wwwwyyykkk/-Fatigue-Detection/docs/答辩流程与讲稿.md

# 疲劳驾驶检测系统 —— 毕业设计答辩

## ⏱ 时间分配（共 15 分钟：10 分钟演示 + 5 分钟问答）

| 环节 | 时长 | 内容 |
|---|---|---|
| ① 开场 | 30s | 自我介绍 + 题目 |
| ② 背景意义 | 1min | 为什么做、市场价值 |
| ③ 系统架构 | 1.5min | 三板分工 + 数据流 |
| ④ 硬件设计 | 1min | 选型 + 接线 |
| ⑤ 软件原理 | 2min | 疲劳检测/预测/哈欠/休息 |
| ⑥ 现场演示 | 3min | 全链路实操 |
| ⑦ 创新点 | 1min | 3 个核心创新 |
| ⑧ 总结展望 | 30s | 局限 + 未来 |

---

## ① 开场（30 秒）

> 各位老师好！我是 XXX，我的毕业设计题目是《基于 ESP32-S3 的疲劳驾驶检测系统》。
> 下面我将从研究背景、系统设计、技术实现、现场演示四个方面进行汇报。

---

## ② 研究背景与意义（1 分钟）

> 根据公安部交通管理局数据，**疲劳驾驶是引发重特大交通事故的首要原因之一**，
> 约占高速公路交通事故的 20%-25%。疲劳驾驶具有突发性、隐蔽性，驾驶员往往在
> 事故发生前自己都意识不到。
>
> 目前市面上的产品分两类：
> - **前装 DMS**（特斯拉、理想等）：需要原厂集成，普通车辆无法加装
> - **后装 DMS**：动辄数千元，且多是"检测到疲劳才报警"的被动响应
>
> 我的设计目标是：**低成本（总成本约 ¥200）、边缘计算、主动预测**的
> 疲劳驾驶检测系统，让普通车辆也能享受疲劳预警保护。

---

## ③ 系统总体架构（1.5 分钟）

> 系统采用**双 ESP32-S3 + 4G 模组 + 云端**的三层架构：

```
┌────────────────────────────────────────────────────┐
│                  云端（Flask 网页）                  │
│      高德地图 · PERCLOS仪表盘 · 事件时间线 · 天气      │
└──────────────────────┬─────────────────────────────┘
                       │ 华为云 IoTDA（MQTT）
┌──────────────────────┴─────────────────────────────┐
│        EG800K 4G 模组（QuecPython）                  │
│        数据透传 · 模拟GPS轨迹 · MQTT上传              │
└──────────────────────┬─────────────────────────────┘
                       │ UART1
┌──────────────────────┴───────────┐  ┌───────────────┐
│   主板 ESP32-S3                   │  │  VirtualGPS    │
│   USB摄像头 → 人脸检测             │←┼→│  按钮/OLED/TTS  │
│   → 眼睛ROI → PERCLOS             │  │  Rainmaker远程 │
│   → 哈欠检测 → 疲劳预测            │  │  ESP-SR语音    │
│   → 休息管理 → TFT显示             │  │               │
└───────────────────────────────────┘  └───────────────┘
```

> **主板**负责核心的视觉疲劳检测，**VirtualGPS** 负责模拟驾驶环境
> （速度/位置/司机/休息请求），**EG800K** 负责 4G 通信上传云端，
> 三块板通过串口和 ESP-NOW 通信，各司其职。

---

## ④ 硬件设计（1 分钟）

> - **主控**：ESP32-S3（240MHz 双核，16MB PSRAM）
> - **摄像头**：USB UVC 摄像头（720P，通过 USB-OTG 接口）
> - **显示**：ST7789 240×320 TFT 彩屏（SPI）
> - **语音**：SYN6288 TTS 语音合成（播报疲劳告警）
> - **通信**：EG800K 4G 模组 + ESP-NOW 无线板间通信
> - **传感器**：MQ3 酒精检测、INMP441 麦克风（语音识别）
>
> 总物料成本约 **¥200**，对比市面后装 DMS 数千元，具有明显成本优势。

---

## ⑤ 软件实现与技术原理（2 分钟）

### 5.1 疲劳检测（PERCLOS）

> 采用国际通用的 **PERCLOS（眼睛闭合时间百分比）** 指标：
> - 摄像头捕获面部 → ESP-DL 人脸检测模型定位人脸
> - 人脸框按比例切出眼睛 ROI → 缩放 96×96 灰度图
> - 送入 MobileNetV2 轻量神经网络（TFLite Micro）判断睁闭眼
> - 滑动窗口 30 帧计算 PERCLOS，阈值联动天气调整
>
> ```
> PERCLOS > 15% 轻度疲劳（晴天）   12% 雨天   10% 雾天
> PERCLOS > 30% 严重疲劳           25%        20%
> ```

### 5.2 打哈欠检测（暗区比例法）

> 传统打哈欠检测需要打哈欠数据集训练模型，我采用**暗区比例法**：
> - 打哈欠时口腔内部形成黑色空洞
> - 计算嘴巴 ROI 中心区域暗像素占比
> - 暗区比 > 35% 且持续 1.5 秒 → 判定为一次哈欠
>
> **零训练、零额外算力**，且不影响主检测链路。

### 5.3 疲劳预测（线性回归）

> 与市面"检测到才报警"不同，我的系统能**预测即将疲劳**：
> - 每 30 秒记录一次 PERCLOS 到环形缓冲（20 点）
> - 每 2 分钟用**线性回归**拟合上升斜率
> - 根据斜率推算到达疲劳阈值的时间
> - TFT 显示"预计 N 分钟后疲劳"+ 预测虚线
>
> 提前 5-15 分钟预警，让驾驶员有充足时间进服务区。

### 5.4 休息管理

> 疲劳告警后进入休息模式：
> - 轻度疲劳 → 建议休息 10 分钟；严重疲劳 → **强制休息 20 分钟**（不可提前退出）
> - 休息结束 → 对比休息前后 PERCLOS 计算**恢复率**
> - 恢复不足 40% → 自动延长休息
> - 休息完成 → **人脸重新验证**，防止换司机规避检测

### 5.5 云端监控

> 疲劳数据通过 4G 实时上传华为云，网页端实时显示：
> - 车辆位置（高德地图）+ 行驶轨迹
> - PERCLOS 仪表盘 + 安全评分
> - 疲劳/哈欠事件时间线
> - **天气联动**：雨雪雾自动降低检测阈值

---

## ⑥ 现场演示（3 分钟）

### 演示准备（提前做好）

```
1. Flask + ngrok 已启动
2. EG800K 已连接 4G（MQTT connect=0）
3. 三块板已烧录最新固件 + 已连接 WiFi
4. 串口 monitor 已开（COM16 主板 / COM18 VirtualGPS）
5. 浏览器打开 ngrok 网页
6. 手机打开 Rainmaker App
```

### 演示流程（对应 10 分钟脚本）

| 时间 | 操作 | 讲解要点 |
|---|---|---|
| 0:00 | 指 TFT + 摄像头 | "边缘 AI，本地推理，不依赖云端" |
| 0:30 | 输入 `demo` 命令 | "开启加速演示，5 秒采样，10 秒预测" |
| 1:00 | Rainmaker 拉 PERCLOS 5%→10% | 正常状态，绿色 |
| 1:30 | 拉到 14% | TFT 预测栏出现 "预测 2min" ← **亮点** |
| 2:00 | 拉到 18% | 触发轻度疲劳，TFT 变黄 |
| 2:30 | 对着摄像头打哈欠 | 哈欠+1，PERCLOS 加成+5% |
| 3:00 | 切服务区 + 按 BUTTON_3 | 进入休息，显示倒计时+恢复率 |
| 3:30 | 展示网页 | 地图 + PERCLOS 仪表盘 + 事件时间线 |
| 4:30 | 语音："Hi ESP，我累了" | ESP-SR 唤醒 → 命令识别 → 记录 |
| 5:00 | 总结 | 三个创新点收尾 |

---

## ⑦ 创新点总结（1 分钟）

> 总结本设计的三个核心创新点：
>
> **① 疲劳预测而非被动检测**
> 市面产品都是"检测到疲劳才报警"，本系统通过线性回归
> 预测 PERCLOS 上升趋势，**提前 5-15 分钟预警**。
>
> **② 零训练打哈欠检测**
> 采用暗区比例法识别口腔黑洞，无需训练数据集，
> 在 ESP32 上零额外算力开销，不影响主检测链路。
>
> **③ 低成本边缘 AI 全链路**
> 从图像采集、疲劳推理到 4G 上传，全部在嵌入式端完成，
> 总成本约 ¥200，并实现了天气联动降阈、远程监控、
> 强制休息管理、人脸身份验证等完整功能闭环。

---

## ⑧ 总结与展望（30 秒）

> 本设计实现了一套完整的疲劳驾驶检测系统，具有低成本、
> 边缘计算、主动预测的特点。由于时间限制，仍有改进空间：
> - 视线偏离/分心检测（Euro NCAP 2026 要求）
> - 真实 GNSS 定位替代模拟 GPS
> - 升级 ESP32-P4（带 NPU）跑更复杂的 LSTM 预测模型
>
> 我的汇报到此结束，谢谢各位老师！恳请老师们批评指正！

---

## ⑨ 问答环节准备（5 分钟）

### Q1：为什么用线性回归而不是机器学习？
> ESP32 资源有限（512KB SRAM），跑 LSTM 需要额外的模型部署
> 和训练数据。线性回归只需 80 字节存储、微秒级计算，
> 在嵌入式端实时运行，且可解释性强。论文调研显示，
> 这是嵌入式疲劳预测的主流轻量方案。

### Q2：PERCLOS 阈值为什么随天气变化？
> 雨雪雾天气能见度差、路面湿滑，驾驶员反应时间需要更长，
> 同样的闭眼比例在恶劣天气下风险更高。因此降阈以提前预警。

### Q3：摄像头夜间能用吗？
> 当前使用可见光摄像头，夜间光照不足时检测精度会下降。
> 这是后续可改进点——换用红外摄像头 + 补光灯可实现全天候检测。
> （诚实说明局限，再给方案）

### Q4：识别一张脸要多久？
> 眼部分类约 1.9 秒/帧，人脸识别约 12.6 秒。人脸识别仅在
> 开机、切司机、人脸长时间丢失时触发，不影响正常 PERCLOS
> 检测频率。

### Q5：断网会怎样？
> EG800K 断网时数据暂存在本地，恢复后补传（待实现，当前
> 演示环境网络稳定）。疲劳检测本身完全本地运行，不依赖网络。

### Q6：如何保证不误报？
> 三层校验：单帧睁闭眼由神经网络判断 → PERCLOS 需 30 帧
> 滑动窗口稳定 → 等级变化需持续采样确认。哈欠检测有
> 1.5 秒时长过滤，说话不会误触发。

---

## 演示 Checklist（答辩当天早上）

- [ ] 三块板充满电/接好电源，共地
- [ ] 摄像头清晰、无遮挡
- [ ] 主板/ VirtualGPS 串口 monitor 各一个
- [ ] Flask 启动 + ngrok 在线
- [ ] EG800K SIM 卡有流量
- [ ] 浏览器网页打开正常
- [ ] Rainmaker App 登录正常
- [ ] 提前跑一遍完整 demo 确认所有功能
- [ ] 备用：U 盘备份固件 bin + 串口工具
