wwwwyyykkk/-Fatigue-Detection/docs/images/全链路数据流图.png

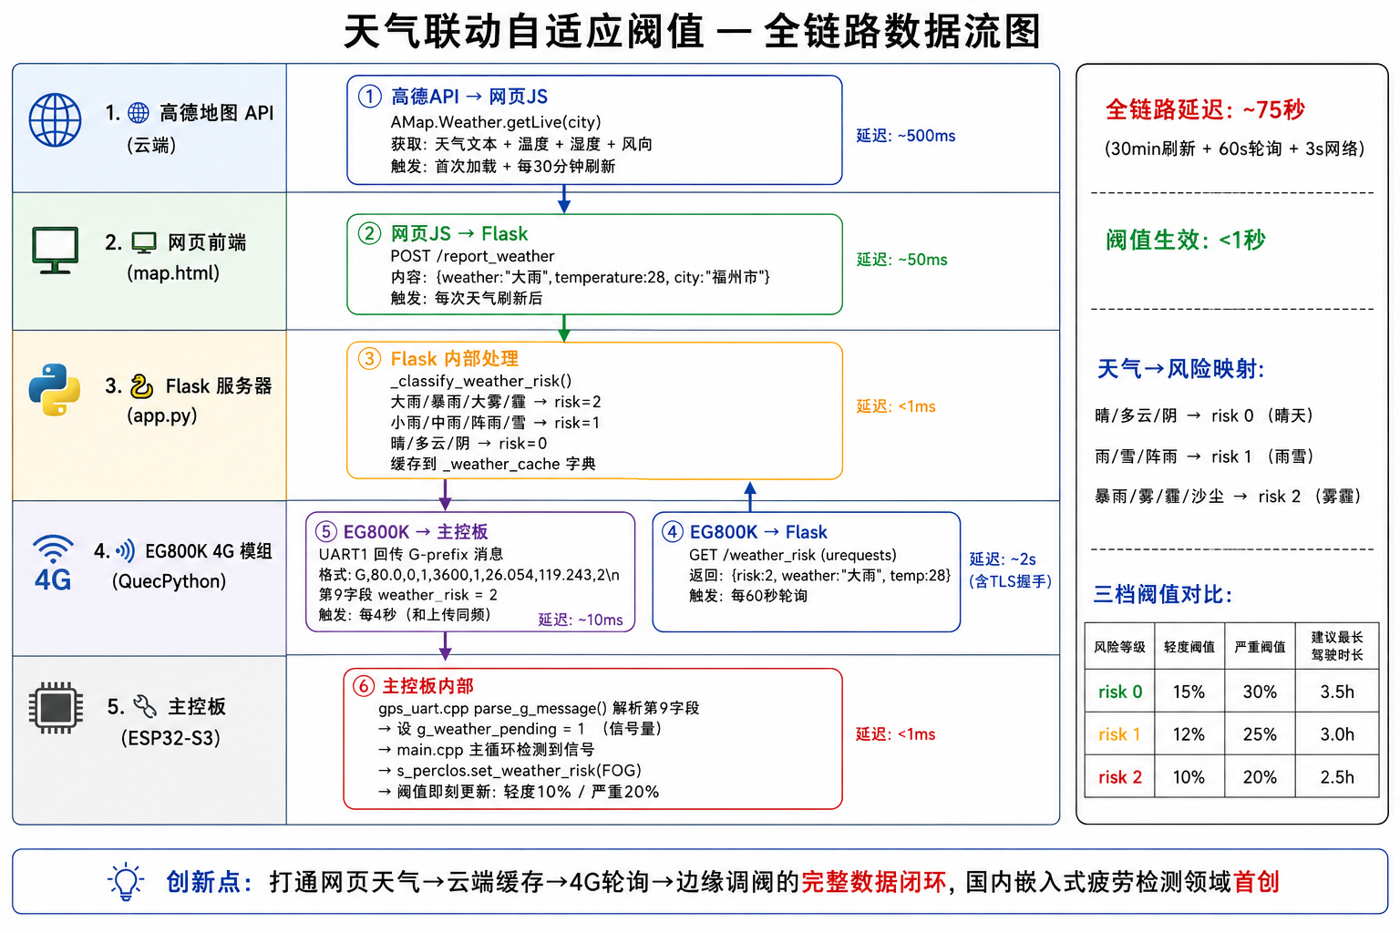
docs/images/全链路数据流图.png
