wwwwyyykkk/-Fatigue-Detection/docs/images/单帧处理管线.png

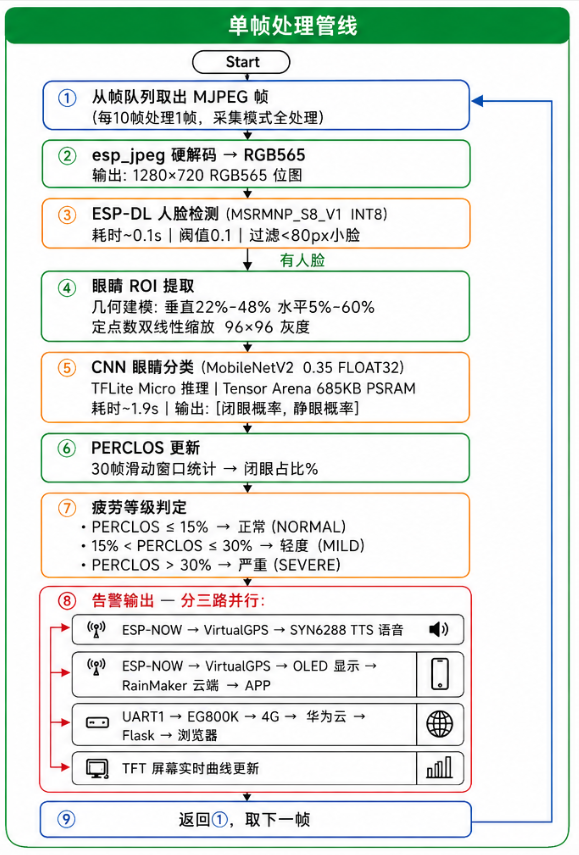
docs/images/单帧处理管线.png
