wwwwyyykkk/-Fatigue-Detection/virtualgps/ESP32S3引脚图.png

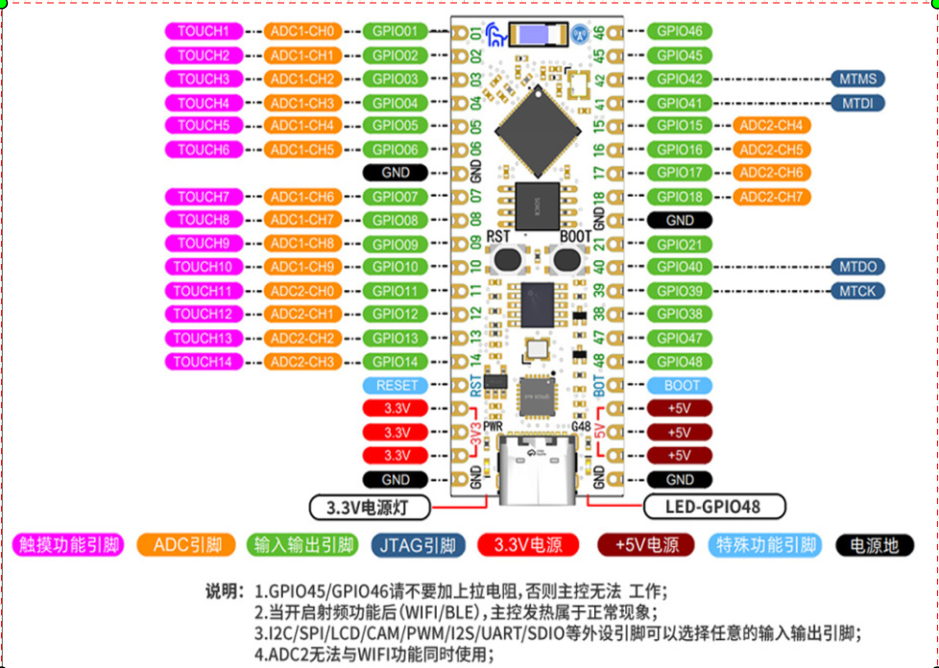
virtualgps/ESP32S3引脚图.png
