wwwwyyykkk/-Fatigue-Detection/virtualgps/ESP32原理图引脚.png

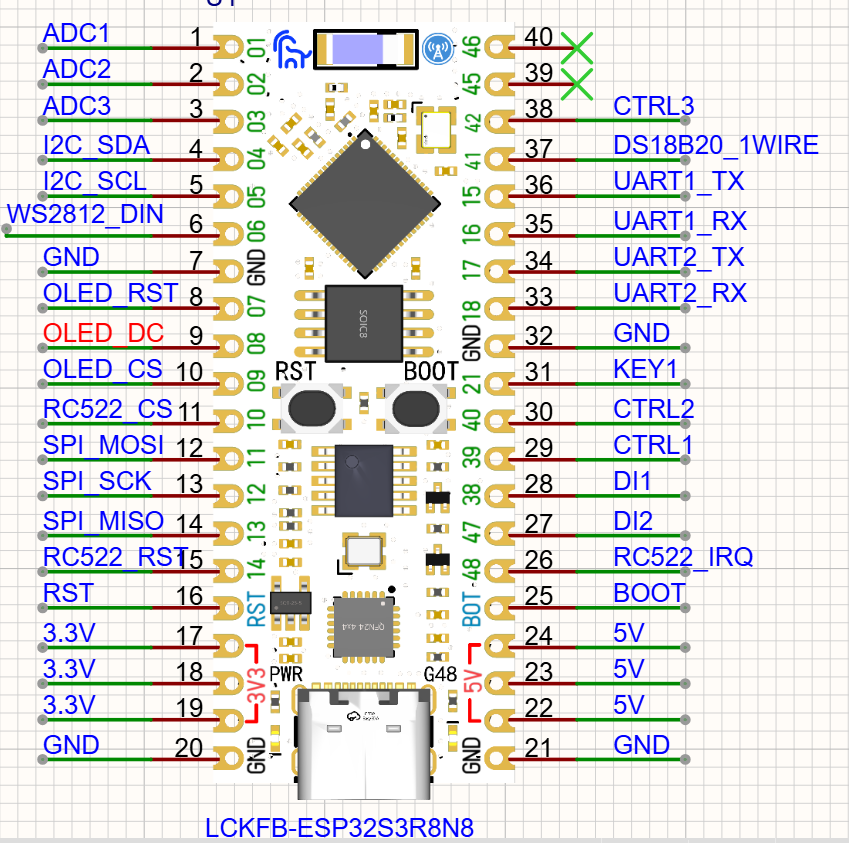
virtualgps/ESP32原理图引脚.png
