wwwwyyykkk/-Fatigue-Detection/main/lv_font_fancy_44.c

/* lv_font_fancy_44.c — HOLLOW script clock font (thicken 3) */
#include "lvgl.h"

static const lv_font_fmt_txt_glyph_dsc_t glyph_dsc[] = {
    {.bitmap_index = 0, .adv_w = 512, .box_w = 32, .box_h = 56, .ofs_x = 0, .ofs_y = 0},
    {.bitmap_index = 224, .adv_w = 256, .box_w = 16, .box_h = 56, .ofs_x = 0, .ofs_y = 0},
    {.bitmap_index = 336, .adv_w = 512, .box_w = 32, .box_h = 56, .ofs_x = 0, .ofs_y = 0},
    {.bitmap_index = 560, .adv_w = 512, .box_w = 32, .box_h = 56, .ofs_x = 0, .ofs_y = 0},
    {.bitmap_index = 784, .adv_w = 512, .box_w = 32, .box_h = 56, .ofs_x = 0, .ofs_y = 0},
    {.bitmap_index = 1008, .adv_w = 512, .box_w = 32, .box_h = 56, .ofs_x = 0, .ofs_y = 0},
    {.bitmap_index = 1232, .adv_w = 512, .box_w = 32, .box_h = 56, .ofs_x = 0, .ofs_y = 0},
    {.bitmap_index = 1456, .adv_w = 512, .box_w = 32, .box_h = 56, .ofs_x = 0, .ofs_y = 0},
    {.bitmap_index = 1680, .adv_w = 512, .box_w = 32, .box_h = 56, .ofs_x = 0, .ofs_y = 0},
    {.bitmap_index = 1904, .adv_w = 512, .box_w = 32, .box_h = 56, .ofs_x = 0, .ofs_y = 0},
    {.bitmap_index = 2128, .adv_w = 512, .box_w = 32, .box_h = 56, .ofs_x = 0, .ofs_y = 0},
    {.bitmap_index = 2352, .adv_w = 512, .box_w = 32, .box_h = 56, .ofs_x = 0, .ofs_y = 0},
    {.bitmap_index = 2576, .adv_w = 256, .box_w = 16, .box_h = 56, .ofs_x = 0, .ofs_y = 0},
};

static const uint8_t glyph_bitmap[] = {
    // U+002D '-'
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
};

static const uint16_t unicode_list[] = {
    0x0000, // '-' U+002D
    0x0001, // '.' U+002E
    0x0003, // '0' U+0030
    0x0004, // '1' U+0031
    0x0005, // '2' U+0032
    0x0006, // '3' U+0033
    0x0007, // '4' U+0034
    0x0008, // '5' U+0035
    0x0009, // '6' U+0036
    0x000A, // '7' U+0037
    0x000B, // '8' U+0038
    0x000C, // '9' U+0039
    0x000D, // ':' U+003A
};

static const lv_font_fmt_txt_cmap_t cmaps[] = {
    {
        .range_start = 0x002D,
        .range_length = 0xE,
        .glyph_id_start = 0,
        .unicode_list = unicode_list,
        .glyph_id_ofs_list = NULL,
        .list_length = 13,
        .type = LV_FONT_FMT_TXT_CMAP_SPARSE_TINY,
    }
};

static const lv_font_fmt_txt_dsc_t font_dsc = {
    .glyph_bitmap = glyph_bitmap,
    .glyph_dsc = glyph_dsc,
    .cmaps = cmaps,
    .kern_dsc = NULL,
    .kern_scale = 0,
    .cmap_num = 1,
    .bpp = 1,
    .kern_classes = 0,
    .bitmap_format = LV_FONT_FMT_TXT_PLAIN,
};

const lv_font_t lv_font_fancy_44 = {
    .dsc = &font_dsc,
    .get_glyph_dsc = lv_font_get_glyph_dsc_fmt_txt,
    .get_glyph_bitmap = lv_font_get_bitmap_fmt_txt,
    .line_height = 56,
    .base_line = 0,
    .subpx = LV_FONT_SUBPX_NONE,
    .underline_position = -2,
    .underline_thickness = 1,
};
