wwwwyyykkk/-Fatigue-Detection/virtualgps/main/chinese_font.h

/*
 * chinese_font.h — 16x16 中文点阵字库 (自动生成)
 * 共 30 个汉字，每个 32 字节
 */
#pragma once
#include <stdint.h>

/* [速] GB2312=0xCBD9 */
static const uint8_t f_0xCBD9[32] = {
    0x00, 0x00, 0x00, 0x00, 0x00, 0x40, 0x10, 0x40,
    0x1F, 0xF8, 0x03, 0xF8, 0x02, 0x48, 0x3B, 0xF8,
    0x08, 0xC0, 0x09, 0x70, 0x0B, 0x58, 0x08, 0x40,
    0x37, 0xF8, 0x00, 0x00, 0x00, 0x00, 0x00, 0x00,
};

/* [度] GB2312=0xB6C8 */
static const uint8_t f_0xB6C8[32] = {
    0x00, 0x00, 0x00, 0x00, 0x00, 0x00, 0x00, 0x80,
    0x1F, 0xF8, 0x1A, 0x20, 0x1F, 0xF8, 0x12, 0x20,
    0x13, 0xE0, 0x17, 0xF0, 0x11, 0x20, 0x11, 0xC0,
    0x13, 0xF0, 0x04, 0x08, 0x00, 0x00, 0x00, 0x00,
};

/* [位] GB2312=0xCEBB */
static const uint8_t f_0xCEBB[32] = {
    0x00, 0x00, 0x00, 0x00, 0x00, 0x00, 0x0C, 0xC0,
    0x08, 0x40, 0x0B, 0xF8, 0x18, 0x00, 0x39, 0x30,
    0x09, 0x20, 0x09, 0xA0, 0x08, 0xA0, 0x08, 0x20,
    0x0B, 0xF8, 0x08, 0x00, 0x00, 0x00, 0x00, 0x00,
};

/* [置] GB2312=0xD6C3 */
static const uint8_t f_0xD6C3[32] = {
    0x00, 0x00, 0x00, 0x00, 0x00, 0x00, 0x0F, 0xF0,
    0x0A, 0x50, 0x01, 0x80, 0x1F, 0xF8, 0x07, 0xE0,
    0x00, 0x20, 0x00, 0x20, 0x07, 0xE0, 0x07, 0xE0,
    0x1F, 0xF8, 0x00, 0x00, 0x00, 0x00, 0x00, 0x00,
};

/* [司] GB2312=0xCBBE */
static const uint8_t f_0xCBBE[32] = {
    0x00, 0x00, 0x00, 0x00, 0x00, 0x00, 0x1F, 0xF8,
    0x00, 0x08, 0x1F, 0xE8, 0x00, 0x08, 0x00, 0x08,
    0x08, 0x48, 0x08, 0x48, 0x0F, 0xC8, 0x08, 0x48,
    0x00, 0x38, 0x00, 0x20, 0x00, 0x00, 0x00, 0x00,
};

/* [机] GB2312=0xBBFA */
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
    0x04, 0x40, 0x04, 0x80, 0x05, 0x00, 0x1F, 0xF8,
    0x04, 0x80, 0x04, 0xC0, 0x04, 0x40, 0x07, 0x30,
    0x06, 0x18, 0x00, 0x00, 0x00, 0x00, 0x00, 0x00,
};

/* 字符查找表 (按 GB2312 编码排序) */
typedef struct { uint16_t gb; const uint8_t *data; } chinese_char_t;

static const chinese_char_t chinese_font_table[] = {
    { 0xB1B1, f_0xB1B1 },
    { 0xB3A4, f_0xB3A4 },
    { 0xB3B5, f_0xB3B5 },
    { 0xB5C0, f_0xB5C0 },
    { 0xB6AB, f_0xB6AB },
    { 0xB6C8, f_0xB6C8 },
    { 0xB6CE, f_0xB6CE },
    { 0xB7FE, f_0xB7FE },
    { 0xB9AB, f_0xB9AB },
    { 0xBBFA, f_0xBBFA },
    { 0xBCB1, f_0xBCB1 },
    { 0xBCDD, f_0xBCDD },
    { 0xBCE4, f_0xBCE4 },
    { 0xBEAD, f_0xBEAD },
    { 0xC0EF, f_0xC0EF },
    { 0xC2B7, f_0xC2B7 },
    { 0xC4CF, f_0xC4CF },
    { 0xC6D5, f_0xC6D5 },
    { 0xC7F8, f_0xC7F8 },
    { 0xCAB1, f_0xCAB1 },
    { 0xCABB, f_0xCABB },
    { 0xCBBE, f_0xCBBE },
    { 0xCBD9, f_0xCBD9 },
    { 0xCDA8, f_0xCDA8 },
    { 0xCEB3, f_0xCEB3 },
    { 0xCEBB, f_0xCEBB },
    { 0xCEF1, f_0xCEF1 },
    { 0xCEF7, f_0xCEF7 },
    { 0xD3A6, f_0xD3A6 },
    { 0xD6C3, f_0xD6C3 },
};
#define CHINESE_FONT_COUNT 30

static inline const uint8_t* chinese_font_lookup(uint16_t gb_code) {
    int lo = 0, hi = CHINESE_FONT_COUNT - 1;
    while (lo <= hi) {
        int mid = (lo + hi) / 2;
        if (chinese_font_table[mid].gb == gb_code)
            return chinese_font_table[mid].data;
        if (gb_code < chinese_font_table[mid].gb)
            hi = mid - 1;
        else
            lo = mid + 1;
    }
    return NULL;
}
