wwwwyyykkk/-Fatigue-Detection/tools/parse_hex_dump.py

"""Parse hex dump from ESP32 monitor output to analyze image quality."""
import sys
import numpy as np

hex_data = """484848484848494a4c4c4f4f50504e4b4744424243454545454545424242454545464441414145494846464342413f41484b4d48403832343839353439383739393c3b3b3b3b3b3b3b3b3c3c3c3c3c3c3c3c3c3b3a3a3a3a39393939393936363334
464646464646474949494e4e4e4e4c494643424242444445454545424243444545454240414145484846454342403f4045494b463f3732343839353238373639393b3a3b3b3b3b3b3b3b3c3c3b3b3b3b3b3b3b3a3a3a3a393939393936363334
424242424242444747474a4a4a4c4a494442424242424245454545464643434543424140414145474845434242403f40454545423b34303438393532373736393939393a3a3b3b3b3b3b3c3c3b3a3a3a3a3a3a3a3a3a3a393939393936363333
424242424242434444474848484a4946444242424242424345454545454442434242403f3e40424646454342413f3f3f4243433e3a34303338373232363636393939393939393b3b3b3b3b3c3b3a3a3a3a3a3a3a3a3a39393939393936363333
424242424242414041454546474848454342424242424242444545454545424241413f3e3d3e404545444342403f3f3e3f40403b3833303237363032353636393939393939393a3a3a3b3b3b3a3a3a3a3a3a3a3a3a3939383839393936363333
424242424242403e41424243474845454242424242424242434545464645424240403d3d3d3d404345444242403f3f3e3c3c3c3a353330323536303135363639393939393939393a3a3b3b39393a3a3a3a3a3a3a3a3939363639393936363333
424242424242403e3f3f424243454542424242424242424242444547464542403f3f3e3c3c3c3f43454242423f3f3f3e3c3b38373431303235363031353535363939393939393939393a3b39393a3a3a3a3a3a3a3a3936363539393936363333
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
474747474645454545454545474747474747474745454545454647474747474747494647494949474644434141424445454343424242444646474949494748494a4c4a494a49484642413f3e3e3d3b3939393939393737363637383939393939
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

# Parse hex data - filter out non-hex content (debug lines)
lines = hex_data.strip().split('\n')
img_data = []
for line in lines:
    line = line.strip()
    # Skip lines with debug output - only keep pure hex lines (192 hex chars = 96 bytes)
    # Remove spaces and non-hex characters
    hex_only = ''.join(c for c in line if c in '0123456789abcdefABCDEF')
    if len(hex_only) < 192:  # skip short/incomplete lines
        continue
    # Keep only first 192 chars (96 bytes = one complete row)
    hex_only = hex_only[:192]
    pixels = []
    for i in range(0, len(hex_only), 2):
        hex_pair = hex_only[i:i+2]
        pixels.append(int(hex_pair, 16))
    img_data.append(pixels)

img = np.array(img_data, dtype=np.uint8)
print(f"Image shape: {img.shape}")
print(f"Pixel range: min={img.min()}, max={img.max()}, mean={img.mean():.1f}, std={img.std():.1f}")

# Print a sample of the image for visual inspection (ASCII art)
print("\n--- Image visualization (scaled) ---")
# Downsample to fit terminal
step = 6
for y in range(0, img.shape[0], step):
    line = ""
    for x in range(0, img.shape[1], step):
        block = img[y:y+step, x:x+step]
        avg = block.mean()
        # Map 0-255 to ASCII characters
        if avg < 30: c = '#'  # very dark
        elif avg < 50: c = '@'
        elif avg < 65: c = '%'
        elif avg < 80: c = '+'
        elif avg < 100: c = '-'
        elif avg < 130: c = '.'
        elif avg < 170: c = ':'
        else: c = ' '
        line += c
    print(line)

print("\n--- Pixel value distribution ---")
bins = [0, 30, 50, 70, 90, 110, 130, 150, 200, 256]
labels = ['0-30', '30-50', '50-70', '70-90', '90-110', '110-130', '130-150', '150-200', '200-255']
hist, _ = np.histogram(img, bins=bins)
for label, count in zip(labels, hist):
    pct = count / img.size * 100
    bar = '#' * int(pct)
    print(f"  {label:>8s}: {count:6d} ({pct:5.1f}%) {bar}")

# Check if image looks like open or closed eye
# Open eye: top part dark (pupil), bottom bright (sclera)
top = img[:48, :].mean()
bottom = img[48:, :].mean()
print(f"\nTop half mean: {top:.1f}")
print(f"Bottom half mean: {bottom:.1f}")
print(f"Difference: {bottom - top:.1f}")
if bottom - top > 30:
    print("Pattern: Dark top + Bright bottom -> looks like OPEN eye structure")
elif bottom - top < -20:
    print("Pattern: Bright top + Dark bottom -> unusual")
else:
    print("Pattern: Uniform -> looks like CLOSED eye or dark image")
