wwwwyyykkk/-Fatigue-Detection/(commit log)

2026-10-21 docs: mark buzzer as optional in data flow
2026-10-21 feat: add full ESP-IDF USB UVC firmware, components and docs
    [partitions.csv, partitions_8mb_rainmaker.csv]
